benjamionob6/ArduBalance/ArduBalance/Ardudefine.h

// defines for setting and clearing register bits
// See: http://arduino.cc/forum/index.php/topic,6549.0.html
#ifndef cbi
#define cbi(sfr, bit) (_SFR_BYTE(sfr) &= ~_BV(bit))
#endif
#ifndef sbi
#define sbi(sfr, bit) (_SFR_BYTE(sfr) |= _BV(bit))
#endif
