benjamionob6/ArduBalance/(commit log)

2012-11-12 Started Adding IR Sensor Class Code
2012-11-12 Simple Motor Driver Code
